accelerando-consulting/iot-gillen/production/gillen-Assembly-1v1.pdf

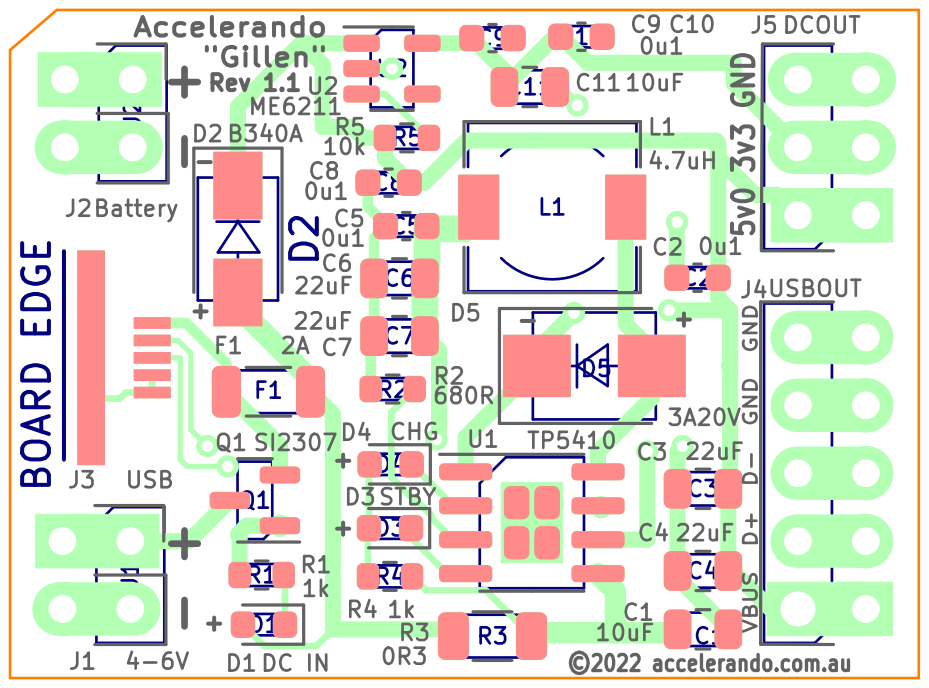
[picture p1: page 1]
