accelerando-consulting/iot-gillen/gillen.kicad_pcb

## KiCad design gillen.kicad_pcb (2024-05-21)

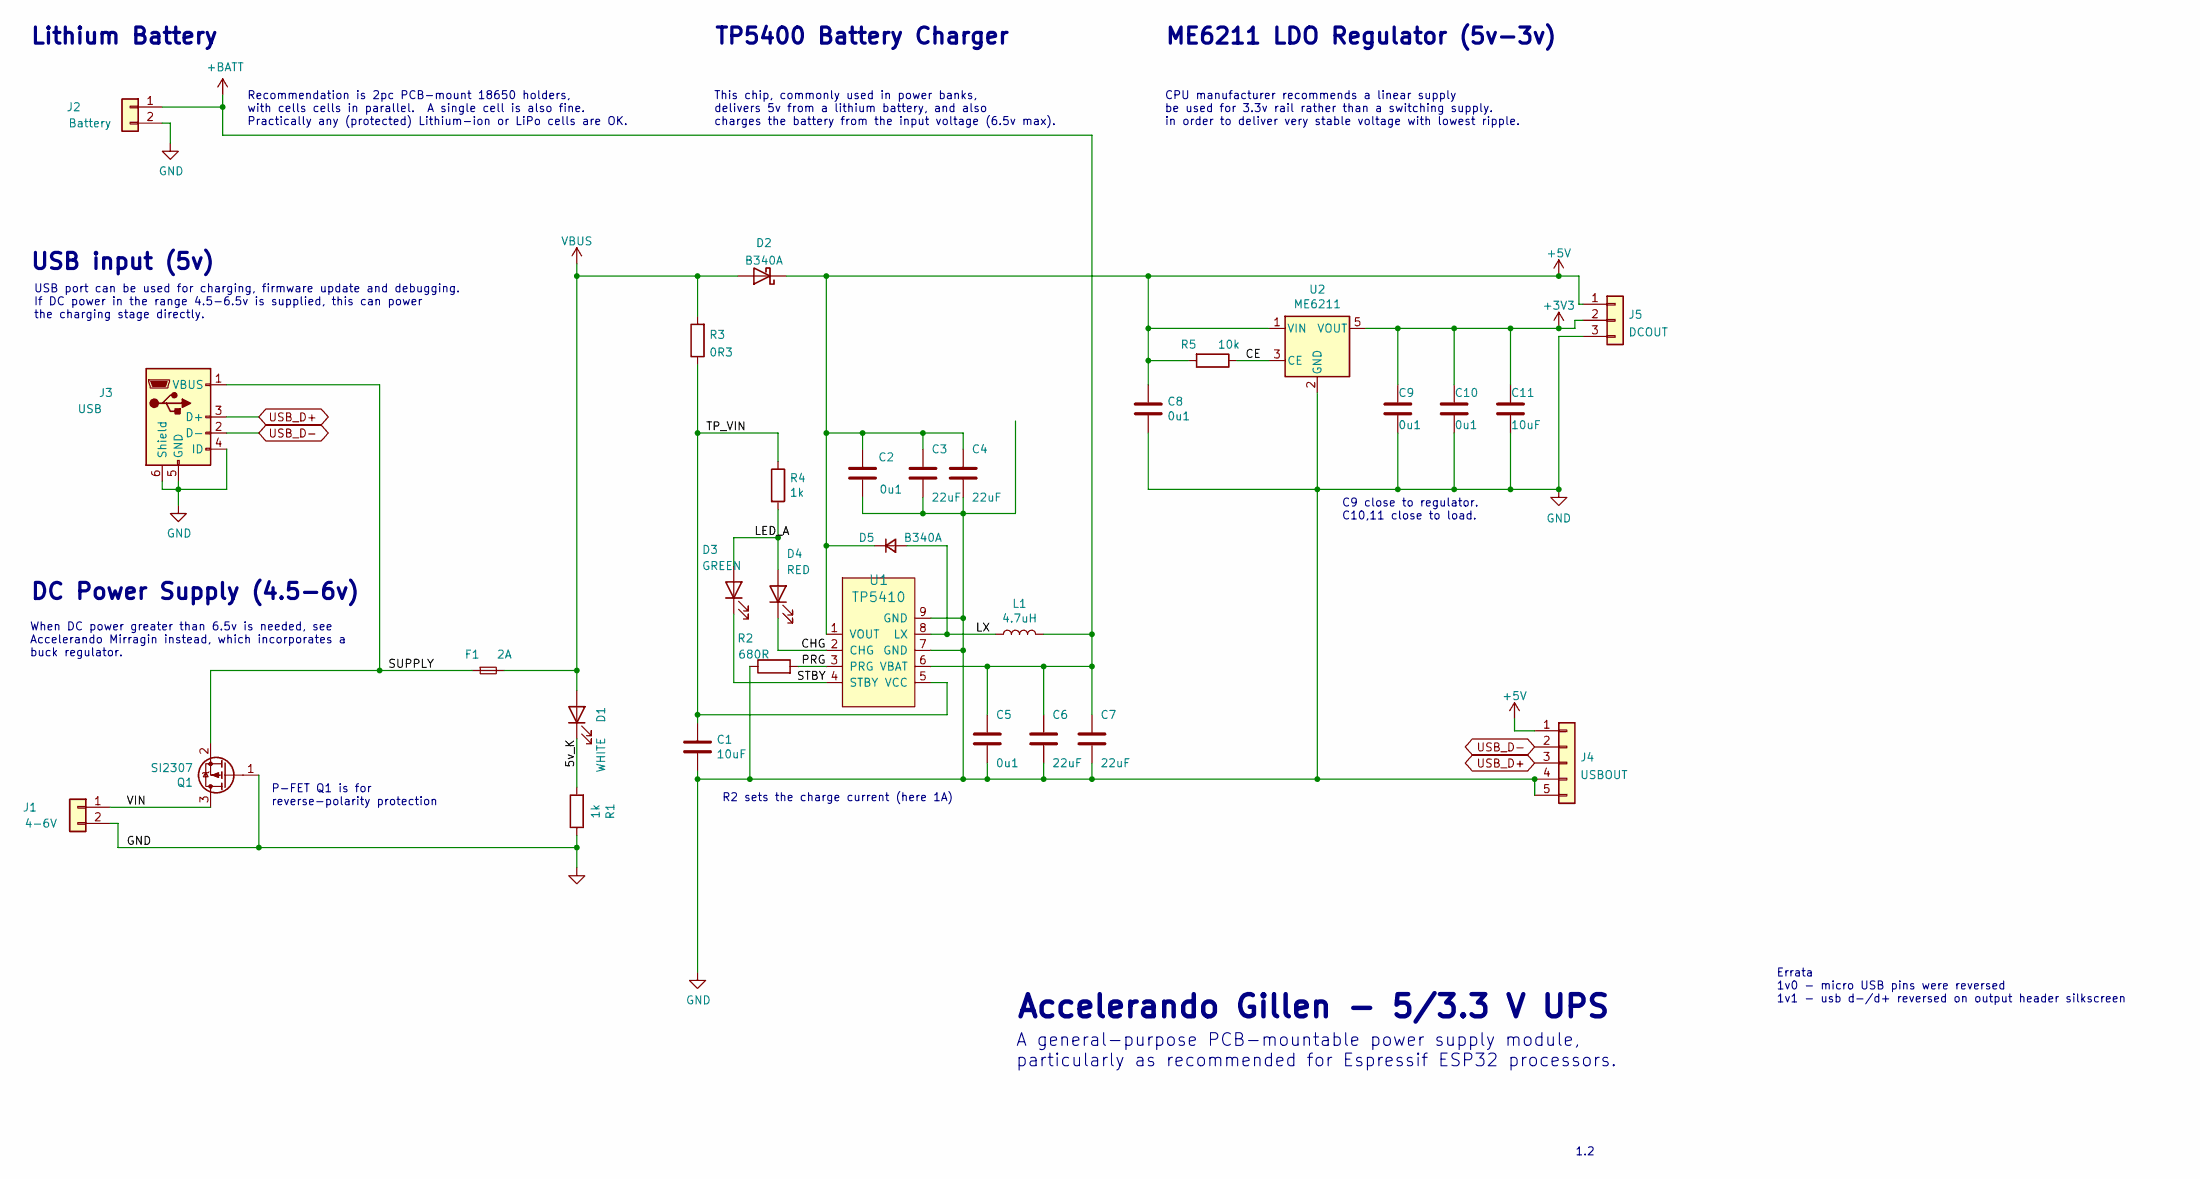
[picture p2: schematic gillen.kicad_sch]

Parts:
C1, C11: 10uF; C_0805_2012Metric
C2, C5, C8, C9, C10: 0u1; C_0603_1608Metric
C3, C4, C6, C7: 22uF; C_0805_2012Metric
D1: WHITE; LED_0603_1608Metric
D2: B340A; D_SMA
D3: GREEN; LED_0603_1608Metric
D4: RED; LED_0603_1608Metric
D5: B340A; D_SMB
F1: 2A; L_1206_3216Metric
J1: 4-6V; Castellated_PinHeader_1x02_P2.54mm
J2: Battery; Castellated_PinHeader_1x02_P2.54mm
J3: USB; USB_Micro_SMD
J4: USBOUT; Castellated_PinHeader_1x05_P2.54mm
J5: DCOUT; Castellated_PinHeader_1x03_P2.54mm
L1: 4.7uH; L_6.3x6.3_H3
Q1: SI2307; SOT-23
R1, R4: 1k; R_0603_1608Metric
R2: 680R; R_0603_1608Metric
R3: 0R3; R_1206_3216Metric
R5: 10k; R_0603_1608Metric
U1: TP5410; SOIC-8-1EP_3.9x4.9mm_P1.27mm_EP2.29x3mm
U2: ME6211; SOT-23-5

Connections:
+3V3: C9.1, C10.1, C11.1, J5.2, U2.5 (VOUT)
+5V: C2.2, C3.1, C4.1, C8.1, D2.1 (K), D5.1 (K), J4.1, J5.1, R5.2, U1.1 (VOUT), U2.1 (VIN)
+BATT: C5.1, C6.1, C7.1, J2.1, L1.2, U1.6 (VBAT)
/5v_K: D1.1 (K), R1.2
/CE: R5.1, U2.3 (CE)
/CHG: D4.1 (K), U1.2 (CHG)
/LED_A: D3.2 (A), D4.2 (A), R4.2
/LX: D5.2 (A), L1.1, U1.8 (LX)
/PRG: R2.2, U1.3 (PRG)
/STBY: D3.1 (K), U1.4 (STBY)
/SUPPLY: F1.1, J3.1 (VBUS), Q1.2 (S)
/TP_VIN: C1.1, R3.1, R4.1, U1.5 (VCC)
/VIN: J1.1, Q1.3 (D)
GND: C1.2, C2.1, C3.2, C4.2, C5.2, C6.2, C7.2, C8.2, C9.2, C10.2, C11.2, J1.2, J2.2, J3.4 (ID), J3.5 (GND), J3.6 (Shield), J4.4, J4.5, J5.3, Q1.1 (G), R1.1, R2.1, U1.7 (GND), U1.9 (GND), U2.2 (GND)
USB_D+: J3.3 (D+), J4.3
USB_D-: J3.2 (D-), J4.2
VBUS: D1.2 (A), D2.2 (A), F1.2, R3.2

Notes on the sheet:
R2 sets the charge current (here 1A)
DC Power Supply (4.5-6v)
USB input (5v)
USB port can be used for charging, firmware update and debugging. If DC power in the range 4.5-6.5v is supplied, this can power the charging stage directly.
P-FET Q1 is for reverse-polarity protection
CPU manufacturer recommends a linear supply be used for 3.3v rail rather than a switching supply. in order to deliver very stable voltage with lowest ripple.
TP5400 Battery Charger
When DC power greater than 6.5v is needed, see Accelerando Mirragin instead, which incorporates a buck regulator.
Lithium Battery
This chip, commonly used in power banks, delivers 5v from a lithium battery, and also charges the battery from the input voltage (6.5v max).
Recommendation is 2pc PCB-mount 18650 holders, with cells cells in parallel. A single cell is also fine. Practically any (protected) Lithium-ion or LiPo cells are OK.
Accelerando Gillen - 5/3.3 V UPS
Errata 1v0 - micro USB pins were reversed 1v1 - usb d-/d+ reversed on output header silkscreen
1.2
C9 close to regulator. C10,11 close to load.
A general-purpose PCB-mountable power supply module, particularly as recommended for Espressif ESP32 processors.
ME6211 LDO Regulator (5v-3v)

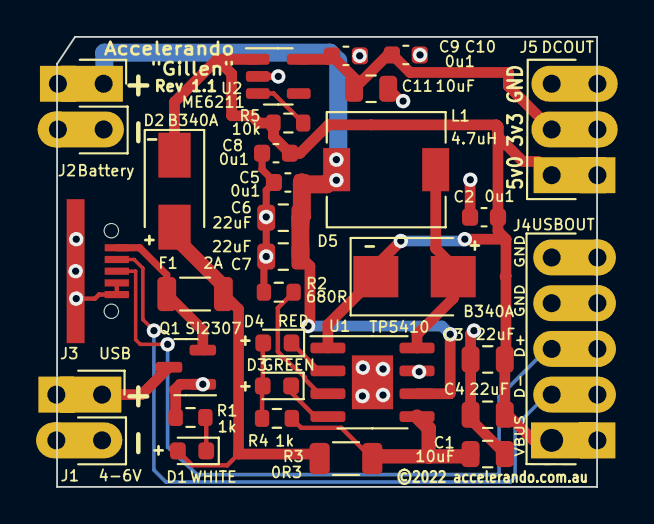
[picture p3: board gillen.kicad_pcb from above]

Board: 2 copper layers, 30.0 x 25.0 mm, 31 parts (0 on the bottom side), 17 nets.
