accelerando-consulting/iot-gillen/(commit log)

2022-07-31 Gillen v1.1 - tps5410 power supply
    [gillen.kicad_pcb, gillen.kicad_sch]
2024-05-21 Address DRC and tidy up assembly info
    [gillen.kicad_pcb, gillen.kicad_sch]
