accelerando-consulting/iot-gillen/(notices)

Notices in the files:
gillen.kicad_pcb:
©2022 accelerando.com.au
